juliuskdjnr/SCAS/schematics/Circuit Diagram.jpeg

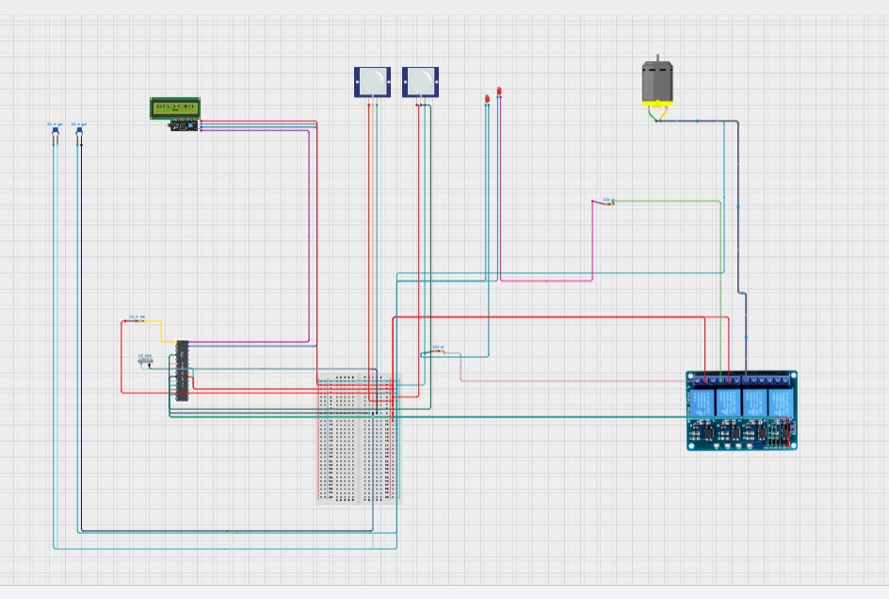
schematics/Circuit Diagram.jpeg
