juliuskdjnr/SCAS/images/Pic 9.jpeg

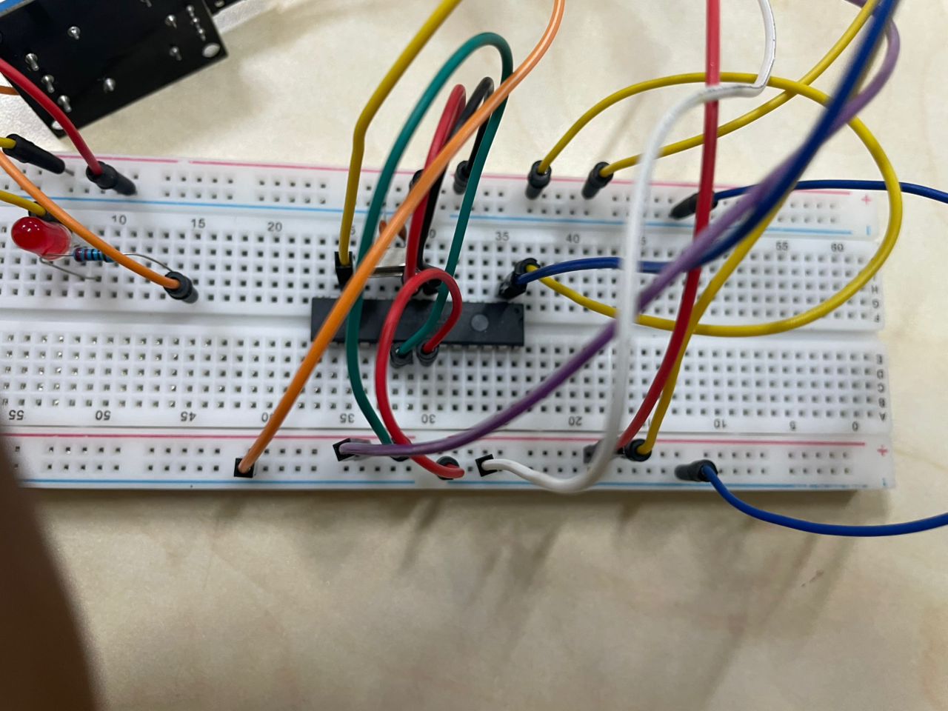
images/Pic 9.jpeg
