juliuskdjnr/SCAS/images/Pic 3.jpeg

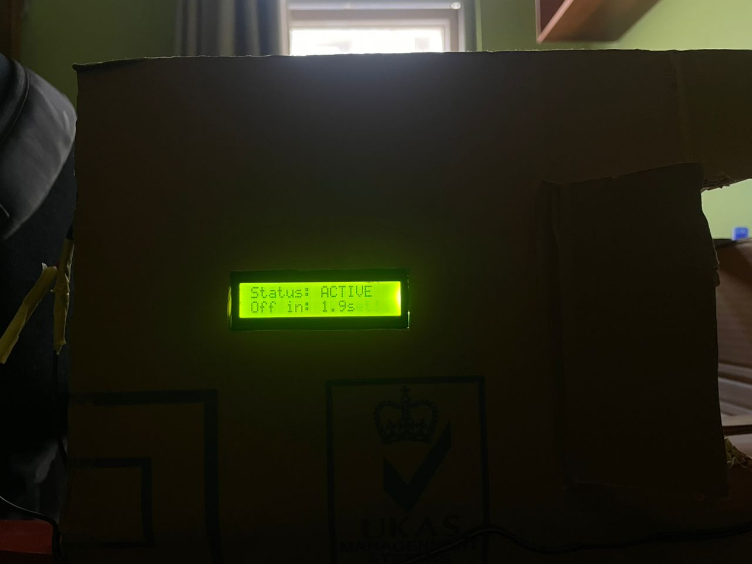
images/Pic 3.jpeg
