juliuskdjnr/SCAS/images/Pic 5.jpeg

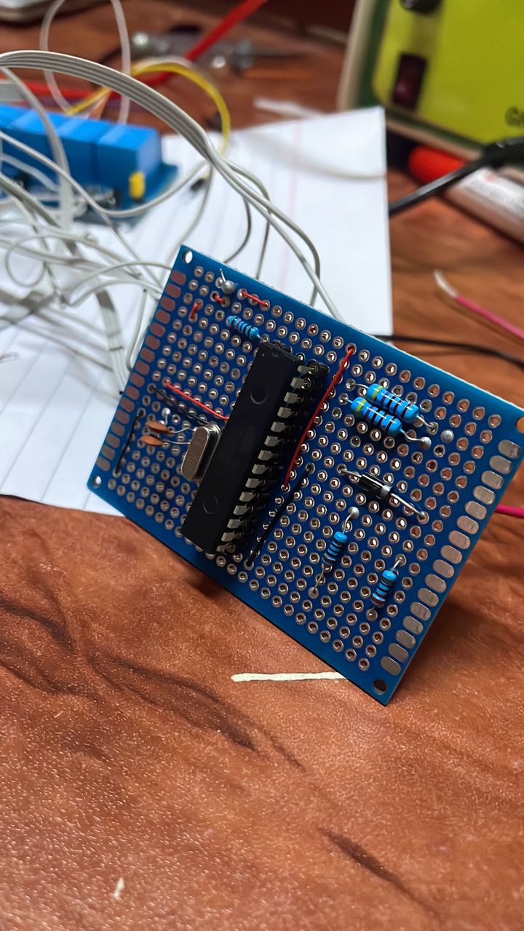
images/Pic 5.jpeg
