juliuskdjnr/SCAS/images/Pic 6.jpeg

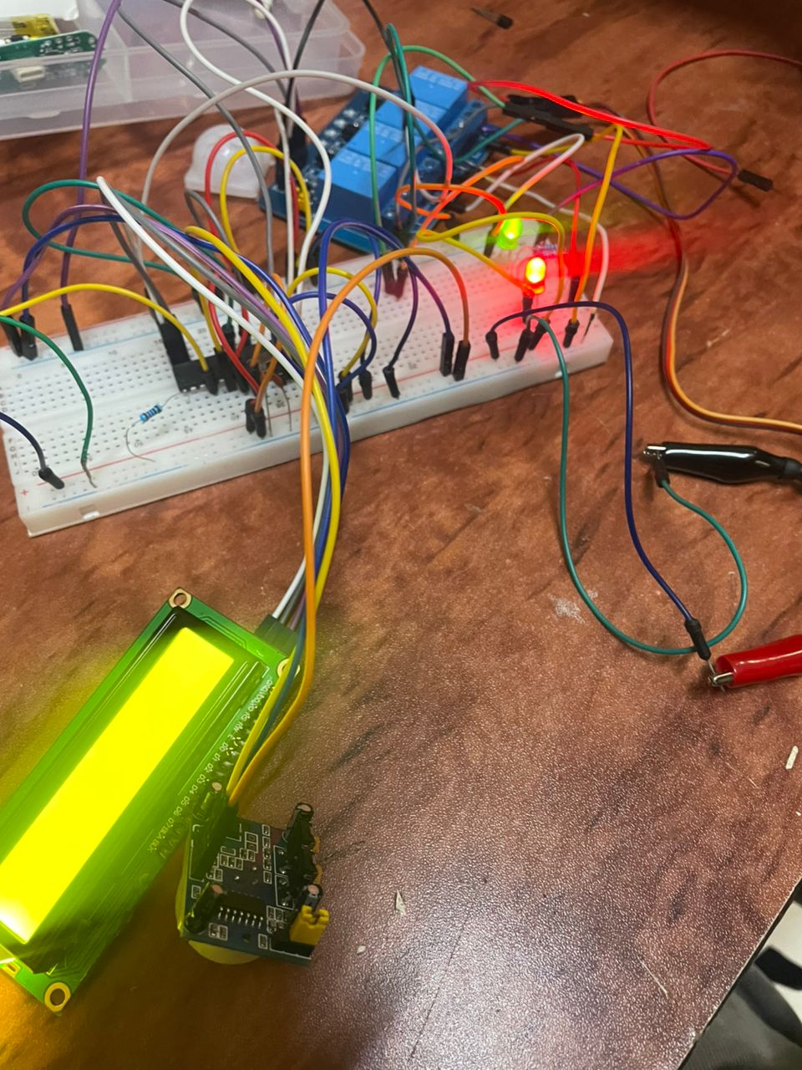
images/Pic 6.jpeg
