juliuskdjnr/SCAS/images/Pic 7.jpeg

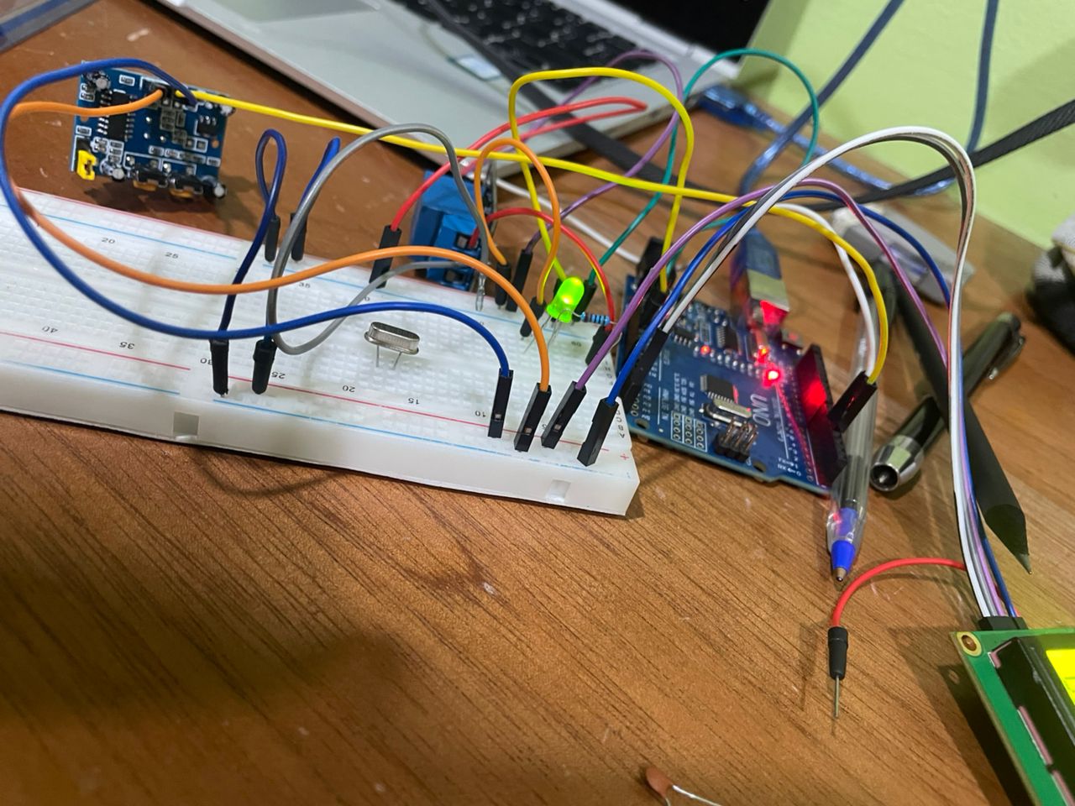
images/Pic 7.jpeg
