juliuskdjnr/SCAS/images/Pic 8.jpeg

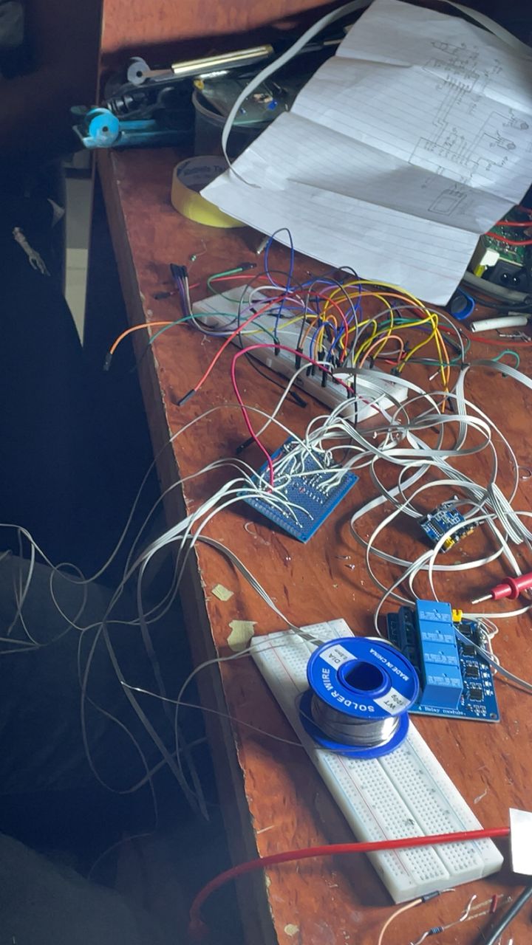
images/Pic 8.jpeg
